PA3EFR/Roger_Beep/WhatsApp Image 2026-11-09 at 14.36.36.jpeg

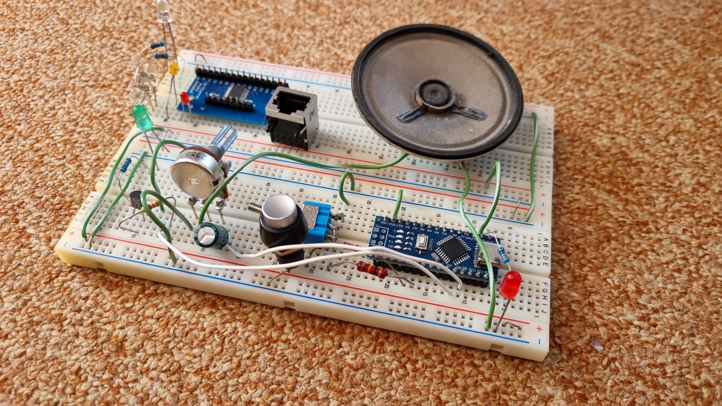
WhatsApp Image 2026-11-09 at 14.36.36.jpeg
