PA3EFR/Roger_Beep/Schematic_RogerBeep_2026-11-09.pdf

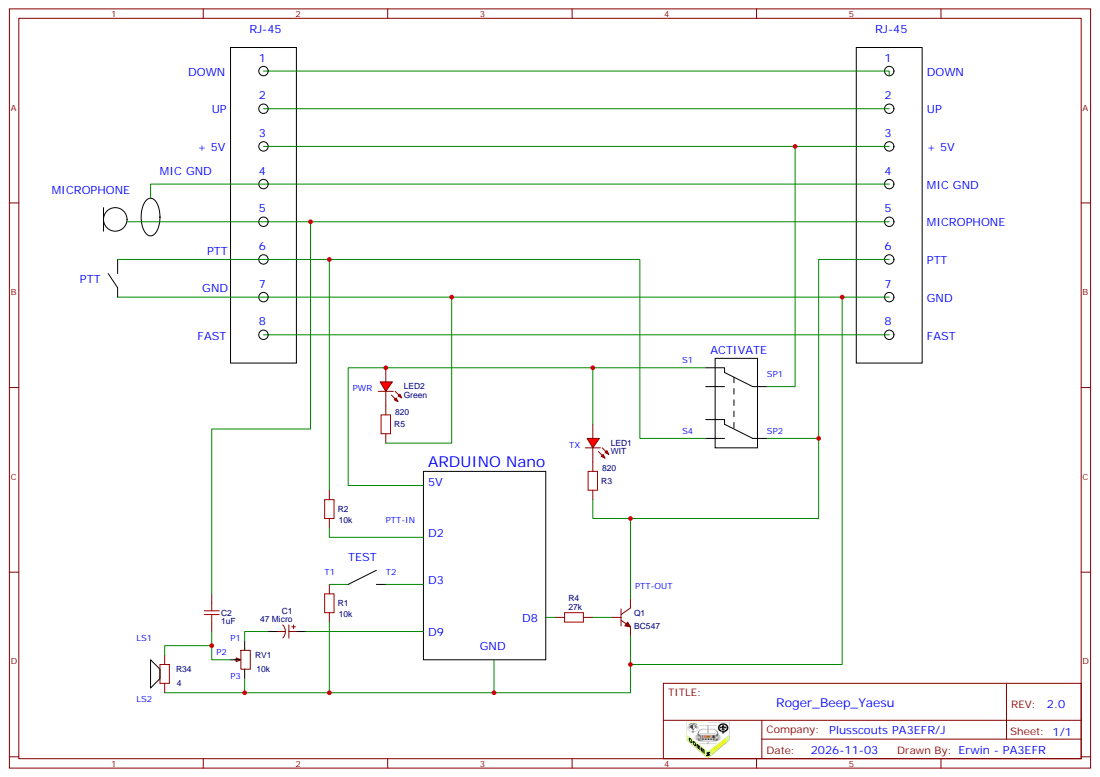
[picture p2: page 1]
