PA3EFR/Roger_Beep/PCB_PCB_RogerBeep_2026-11-09.pdf

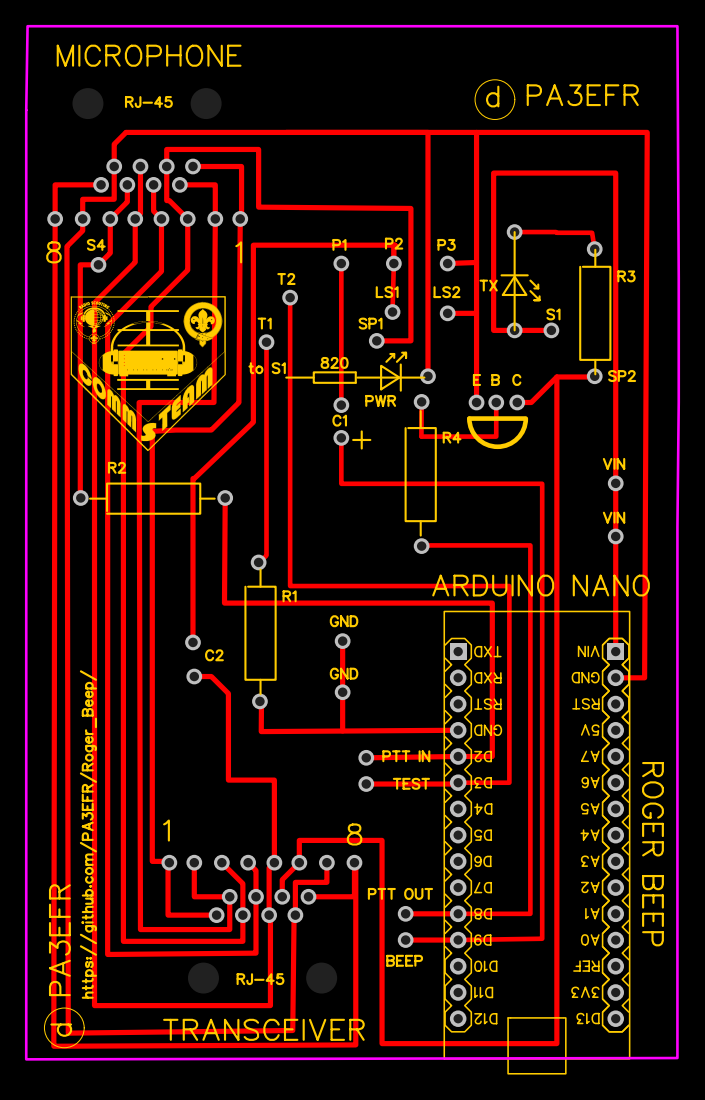
[picture p3: page 1]
